routevegetable/Hex_Lattice_CAD/Viewer/docs/glossary.md

# Glossary

Words this project uses in a particular way. Where a term is ordinary English
somewhere else, this is what it means here.

## The structure

**Lattice** — the physical thing: a honeycomb of LED-lit edges. Everything
else is a way of addressing part of it.

**Module** — one physical board. A module spans **two tiles** across and one
down, which is why `LatticeWriter` is built with `COLS / 2`.

**Tile** — the unit the geometry is written in: one hexagon's worth of edges
and vertices, addressed `graph.TILE[x, y]`. The grid **wraps** in both
directions, so tile `(-1, 0)` is the one at the far right. Code that measures
distance or direction has to fold the result the short way round — see
`wrapped_step` in `fields/trace.py`.

**Edge class** — `A`–`F`, the six edges belonging to a tile. `C` and `F` are
the vertical ones.

**Edge** — an edge class plus a tile. An `EdgeRef`.

**End** — one end of an edge, `top` or `bottom`. An `EndRef`. This is the
smallest thing a field has a value for, and the thing the renderer writes to.
Note that an end is also *a direction*: travelling "out through an end" means
going from it to the other end of its edge.

**Vertex class** — `ABC`, `ABF`, `CDE`, `DEF`, each named for the edges that
meet there. Within a tile they stack bottom to top in that order: DEF, CDE,
ABC, ABF.

**Vertex** — a vertex class plus a tile. Three ends meet at one.
`ends_cw()` returns them clockwise, and **index 0 is always the vertical**.
At a CDE or an ABF that vertical points *up*; at a DEF or an ABC it points
*down*. That asymmetry is why `FireField` branches at DEF and ABC and goes
straight on everywhere else.

**Row** — a horizontal line of vertices. Four rows to a tile, so a lattice
`graph.height` tiles tall has `graph.height * 4` of them. Every step of an
upward path crosses exactly one.

**Filament** — one of the four LED runs at an end. `lattice[end][0..3]`.
Eight pixels to an edge.

## The effect chain

**Field** — AKA a 'scalar field'. A thing which produces some scalar value for every 'end' in the lattice.
A field is essentially a function: `get(now, end) -> float`.
Fields are expressions, built from combining other fields with operators like `+ - * /`.
Fields are attached to parts of the control surface - knobs/CCs and notes.
A field may share a control with another field.
Fields plug into **slots**.

**Effect** — Code which draws on the lattice. An effect has a number of **slots**, which receive values from fields.
An effect is essentially a function: `render(now, lattice, graph)`.
Effects are applied 'in order'. Note that it doesn't output things to draw - instead,
it mutates the latticewriter - this allows an effect to operate on the outputs of previous effects,
for the sake of blending and other transformations.

**Slot** — A thing on an effect that a field plugs into. It has a name.

**Muted** — An effect that is silenced without leaving the patch. It is skipped
when drawing, so the rig looks as if it were not there, while its slots keep
their fields. The patch records the effects that are muted (`muted`);
a patch that does not say has none muted.

**Patch** — An assignment of fields to slots, and a set of control surface CC values.
This is everything that makes a given effect chain's behavior.
The whole patch is replaced on post by the UI, which sends every slot it
knows about even when only one of them changed. A patch is the whole picture
to whoever applies it: a slot it does not mention ends up empty.

**Preset** — a numbered patch, 0–15, one `presets/NN.json` each. Every slot in
the bank always holds a patch; one with no file holds a patch that says
nothing, which applies cleanly and blanks the rig.

**Bank** — `PresetBank`. Holds two copies of every preset: the **cache**, which
is live and may have been edited, and the **stored** copy, which is what is on
disk.

**Dirty** — a preset whose cache differs from its file. Shown as an amber
number in the preset list and an amber dot on the preset chip. Saving writes
the cache out; reverting throws it away and reads the file back.

**Rig** — the *vocabulary*, as opposed to the settings: which fields exist,
which slots exist (including empty ones), what the bank holds. Served by
`/rig`. A patch names things; the rig says what there is to name.

**Console** — the one thread-safe way in. The render loop holds its lock for a
whole frame, so the API thread can never land a patch halfway through one.

## MIDI

**Control** — a knob or a pad the instrument watches. `cc 77`, `note 42`.

**Comment** — what a control is *for*, as `field.role` — `rotary.period`,
`fire.rate`. A control can have several, because more than one field can watch
the same knob. Shown in the knob readout and on the Configuration → MIDI page.

**`MIDIFor`** — a MIDI object that names what it is asking on behalf of.
`midi.for_("rotary").cc(KA5, "period")` leaves the comment `rotary.period`.
Fields are handed one of these rather than the MIDI object itself.

**Watched** — a control something actually asked for. A stray that merely
turned up on the wire (a bank select, an all-notes-off) still gets recorded so
it can be seen arriving, but it is not a setting and never enters a preset.
That filter is what keeps **dirty** meaningful: the fold only merges, never
prunes, so folding strays would re-dirty a just-committed preset.

**Hidden** — plumbing rather than a knob. The 16 step buttons are hidden: they
are watched and saved, but picking a preset is not someone turning a knob, so
they stay out of the readout.

**Pressure** — a note's aftertouch. Set from the velocity when the key goes
down, moved by polytouch after that, and back to 0 when the key comes up.
Both forms of release clear it: a note-off, and a note-on of velocity 0,
which is how some boxes say the same thing.

**Step buttons** — CCs 20–35, one preset each. A press arrives as 127. A
program change of 0–15 does the same thing.

## The web UI

**Tab bar** — the top row: Controls, Effects, Configuration. Picks which page
is showing. The frame rate, preset chip, save and revert sit to its right.

**Sub bar** — the row under the tabs. What it indexes depends on the tab:
effects, fields, or the parts of the setup.

**Page** — the area below the sub bar, filled by whichever tab is up.

**Slot row** — on the Effects page, one slot of the chosen effect. Tapping it
opens the tree editor underneath.

**Tree editor** — how an expression is built by thumb: each operand is either
a field (𝑓(x)), a constant (a slider) or a `math` node with two operands of
its own. It writes back only when every operand is filled.

**Picker** — the modal over the page, used to choose a field and to list
presets.

**Knob readout** — the bar that appears along the bottom for two seconds
whenever a watched knob moves, showing what it is for, its value and a dial.
Preset loads do not raise it: a knob a preset put back is not one anybody
turned.

**Preset chip** — the top-right button showing which preset is playing, amber
with a dot when it has unsaved edits. Tapping it opens the preset list.

### The v3 page

`/static/v3.html` is a second page onto the same rig, laid out for a desktop. It is
plain static files and reads the same API as the others. Its parts:

**Preset bar** — the row across the top: a cell for each of the first sixteen
presets, save and revert for the one playing, undo and redo, a label for its name, a *named*
menu to play a preset by name, and *save copy as…*. That asks for a name and
shows every number the bank holds, each with the name it has; you pick the one
the copy goes to, starting from the lowest free number past the first sixteen,
and picking one that already holds something asks before it is replaced. The
page then reads the playing preset, writes it to that number with the name and
commits it - the same writes as any other edit. *New preset…* is the same dialog and picker, but what it writes is a blank
patch: every effect is in the chain, no slot has anything plugged in, nothing is
muted, and no knob is listed. It plays the new preset afterwards, ready to fill in.
The page cannot delete a preset: the API has no way to.

**Undo** — the page keeps the last 64 states a preset was in before an edit (muting,
adding, removing or moving an effect, plugging a slot, pointing a control at a
knob), knobs included, and undo and redo walk back and forward through them, as
on the touch layout. Each step is an ordinary write of an ordinary patch, so the
instrument knows nothing about it, and the history is lost when the page is
reloaded. Turning a knob is not an edit of its own and is not undone; it comes
back with the next step, since each record holds where the knobs were. A new
edit after an undo ends redo.

**Effect card** — one effect in the playing preset. Its switch **mutes** it, which is an edit to the preset like any other, its
bin takes it out of the preset, and opening it shows its slots. Cards run down
the left half; a plus adds an effect, at the end. The order of the cards is the
order the effects are drawn in, one on top of the next: drag a card by its grip
to move it, which is an edit to the preset like any other. A button at the right
of the preset bar lets the cards take the whole width of the window, or puts them
back in the left half; it is kept in the browser and is not part of any preset.

**Slot box** — one slot of an open card, with a header that says how it is
driven.

**Drive** — how a slot gets its value: a *constant* (a plain number), a *field*
it follows, or a *formula*.

**Knob** — a dial under a slot for a control that one of its fields asks for,
named `field.role` (for example `param_a.value`) with its cc beside it. Drag it
up and down to turn that knob from the page; it follows the desk when the knob
is turned there. Turning one edits the preset, as a hand on the desk does. Tap
one instead and it waits for you to turn a knob at the desk, then listens to
that one from then on; tap it again to let go. That is an edit too, kept or
dropped with the save and revert buttons in the preset bar.
A turned copy of a rotary, such as `rotary180`, shows the dials of the rotary it copies, since they share the knobs.

**Field menu** — the searchable list for plugging a field into a slot. Fields
come in groups: the rest, faders, pads and artnet. The page works out which group
a field is in from its name and kind. The slots of an effect are listed hue, value,
sat, then the rest A to Z, whatever order the effect declares them in. The page works out which group
a field is in from its name and kind. The slots of an effect are listed hue, value,
sat, then the rest A to Z, whatever order the effect declares them in.

**Hue wheel** — how a hue slot is set: one thumb for a constant, two for the
range of a field, or of a formula that cannot leave 0–1 (fields count as 0–1). Any slot called `hue`, or `hue_` and something, gets it.

**Formula editor** — opened by a slot's ƒ. A formula is made of **operations**,
each of two **operands**; an operand is a field or a constant. Each level is a
nested coloured box. A formula is not applied until every operand is filled in.
In an operation, *swap* exchanges its two sides, *+ outer* makes the whole of it
the first half of a new operation, and × removes it, keeping its first operand;
a *+* on a single operand pairs it with a new one. A part can be dragged onto
another operand of the same formula, and the two **trade places**.

## Running

**Frame** — one pass of the render loop: clear the lattice, read MIDI, let
every effect draw, send it.

**Tick** — `MIDI.tick()`, draining the MIDI port once per frame. Messages take
effect in the order they arrived, and a program change loads its preset on the
spot, so a control sent after one lands on the new preset.

**Art-Net universe** — 512 channels of DMX arriving over UDP 6454, read as an
image. Each tile is a 2×2 square of pixels, one per vertex. Four universes,
each giving `r`, `g`, `b` and their average as fields.
