routevegetable/Hex_Lattice_CAD/MK4S Node.3mf

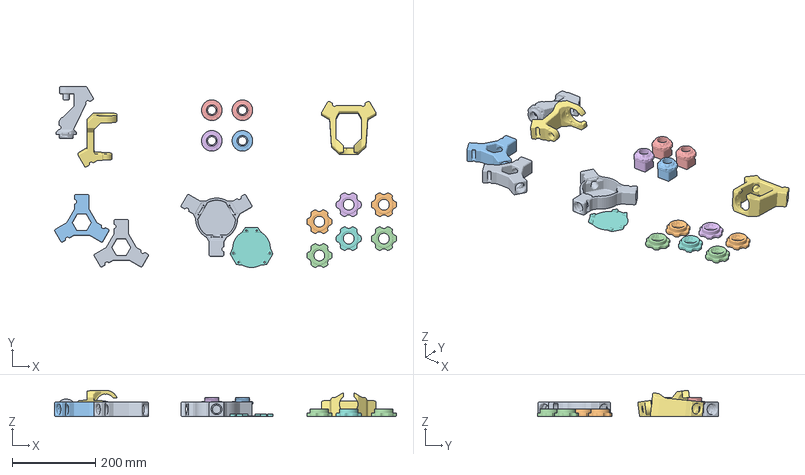
[picture p1: CAD file, 2026-09-07]
MK4S Node.3mf
824.0 x 436.1 x 63.7 mm
Hinge Node 6 - Part 2 (3).stl
Lil Screw Node - Part 3.stl x 6
Lil Node - Part 1 (5).stl x 2
Lil Screw Node - Part 1 (7).stl x 4
Hinge Node 6 - Part 1 (4).stl
Lil Screw Node - Part 1 (6).stl
Smart Node - Part 2 (2).stl
Smart Node - Part 1 (2).stl
