routevegetable/Hex_Lattice_CAD/Module PCB/Hex Lattice.stl

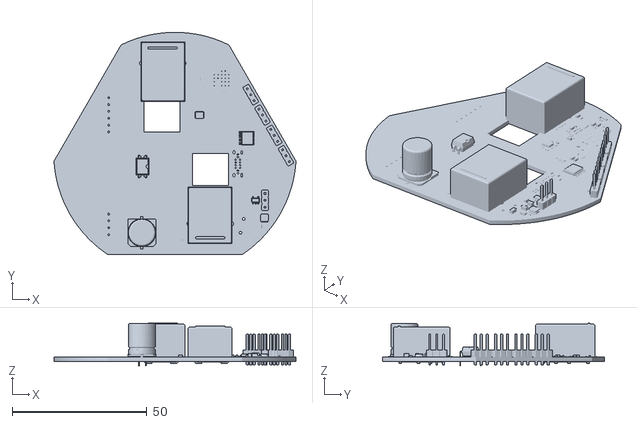
[picture p2: CAD file, 2026-07-01]
Module PCB/Hex Lattice.stl
89.8 x 82.5 x 15.9
