routevegetable/Hex_Lattice_CAD/Bambu Node.3mf

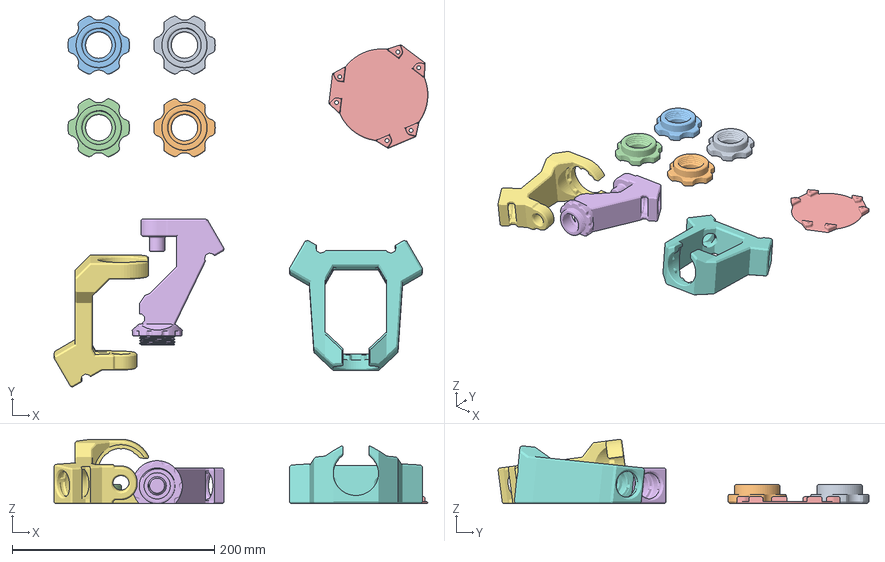
[picture p3: CAD file, 2026-09-05]
Bambu Node.3mf
369.4 x 366.6 x 63.7 mm
Smart Node - Part 2 (1).stl
Hinge Node 6 - Part 2 (3).stl
Hinge Node 6 - Part 1 (4).stl
Lil Screw Node - Part 1 (6).stl
