routevegetable/Hex_Lattice_CAD/Prusa Squish.3mf

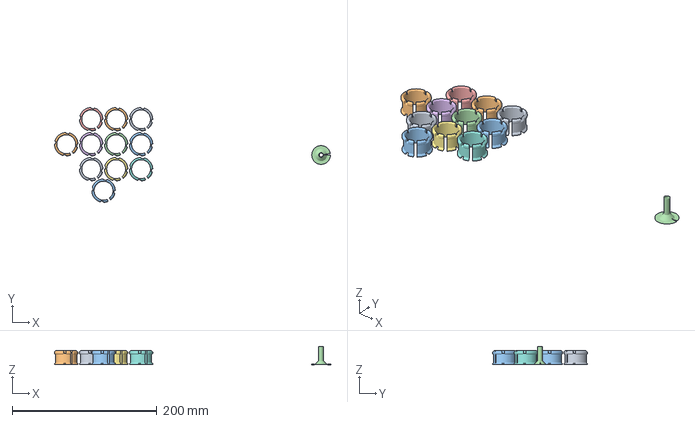
[picture p5: CAD file, 2026-09-05]
Prusa Squish.3mf
380.7 x 130.9 x 25.5 mm
Squish 4 - Part 2 (1).stl x 11
Hinge Node 6 - Part 6.stl
