routevegetable/Hex_Lattice_CAD/Viewer/hinge_obj/todo.md

Multiple room types
Desk
Chop Antennas off the top
Mood lights for the walls
For the 2x4 thing, consider whether we want to have 'straight' as an angle permissible by the hinge.
Coordinate (given the coord of an edge, need a mapping to figure out what module owns it)
Multiple stored profiles for settings
Save/Load profiles with downloadable json
Fake people
