routevegetable/Hex_Lattice_CAD/Module PCB/Hex Lattice.kicad_pcb

## KiCad design Module PCB/Hex Lattice.kicad_pcb (2026-07-01)

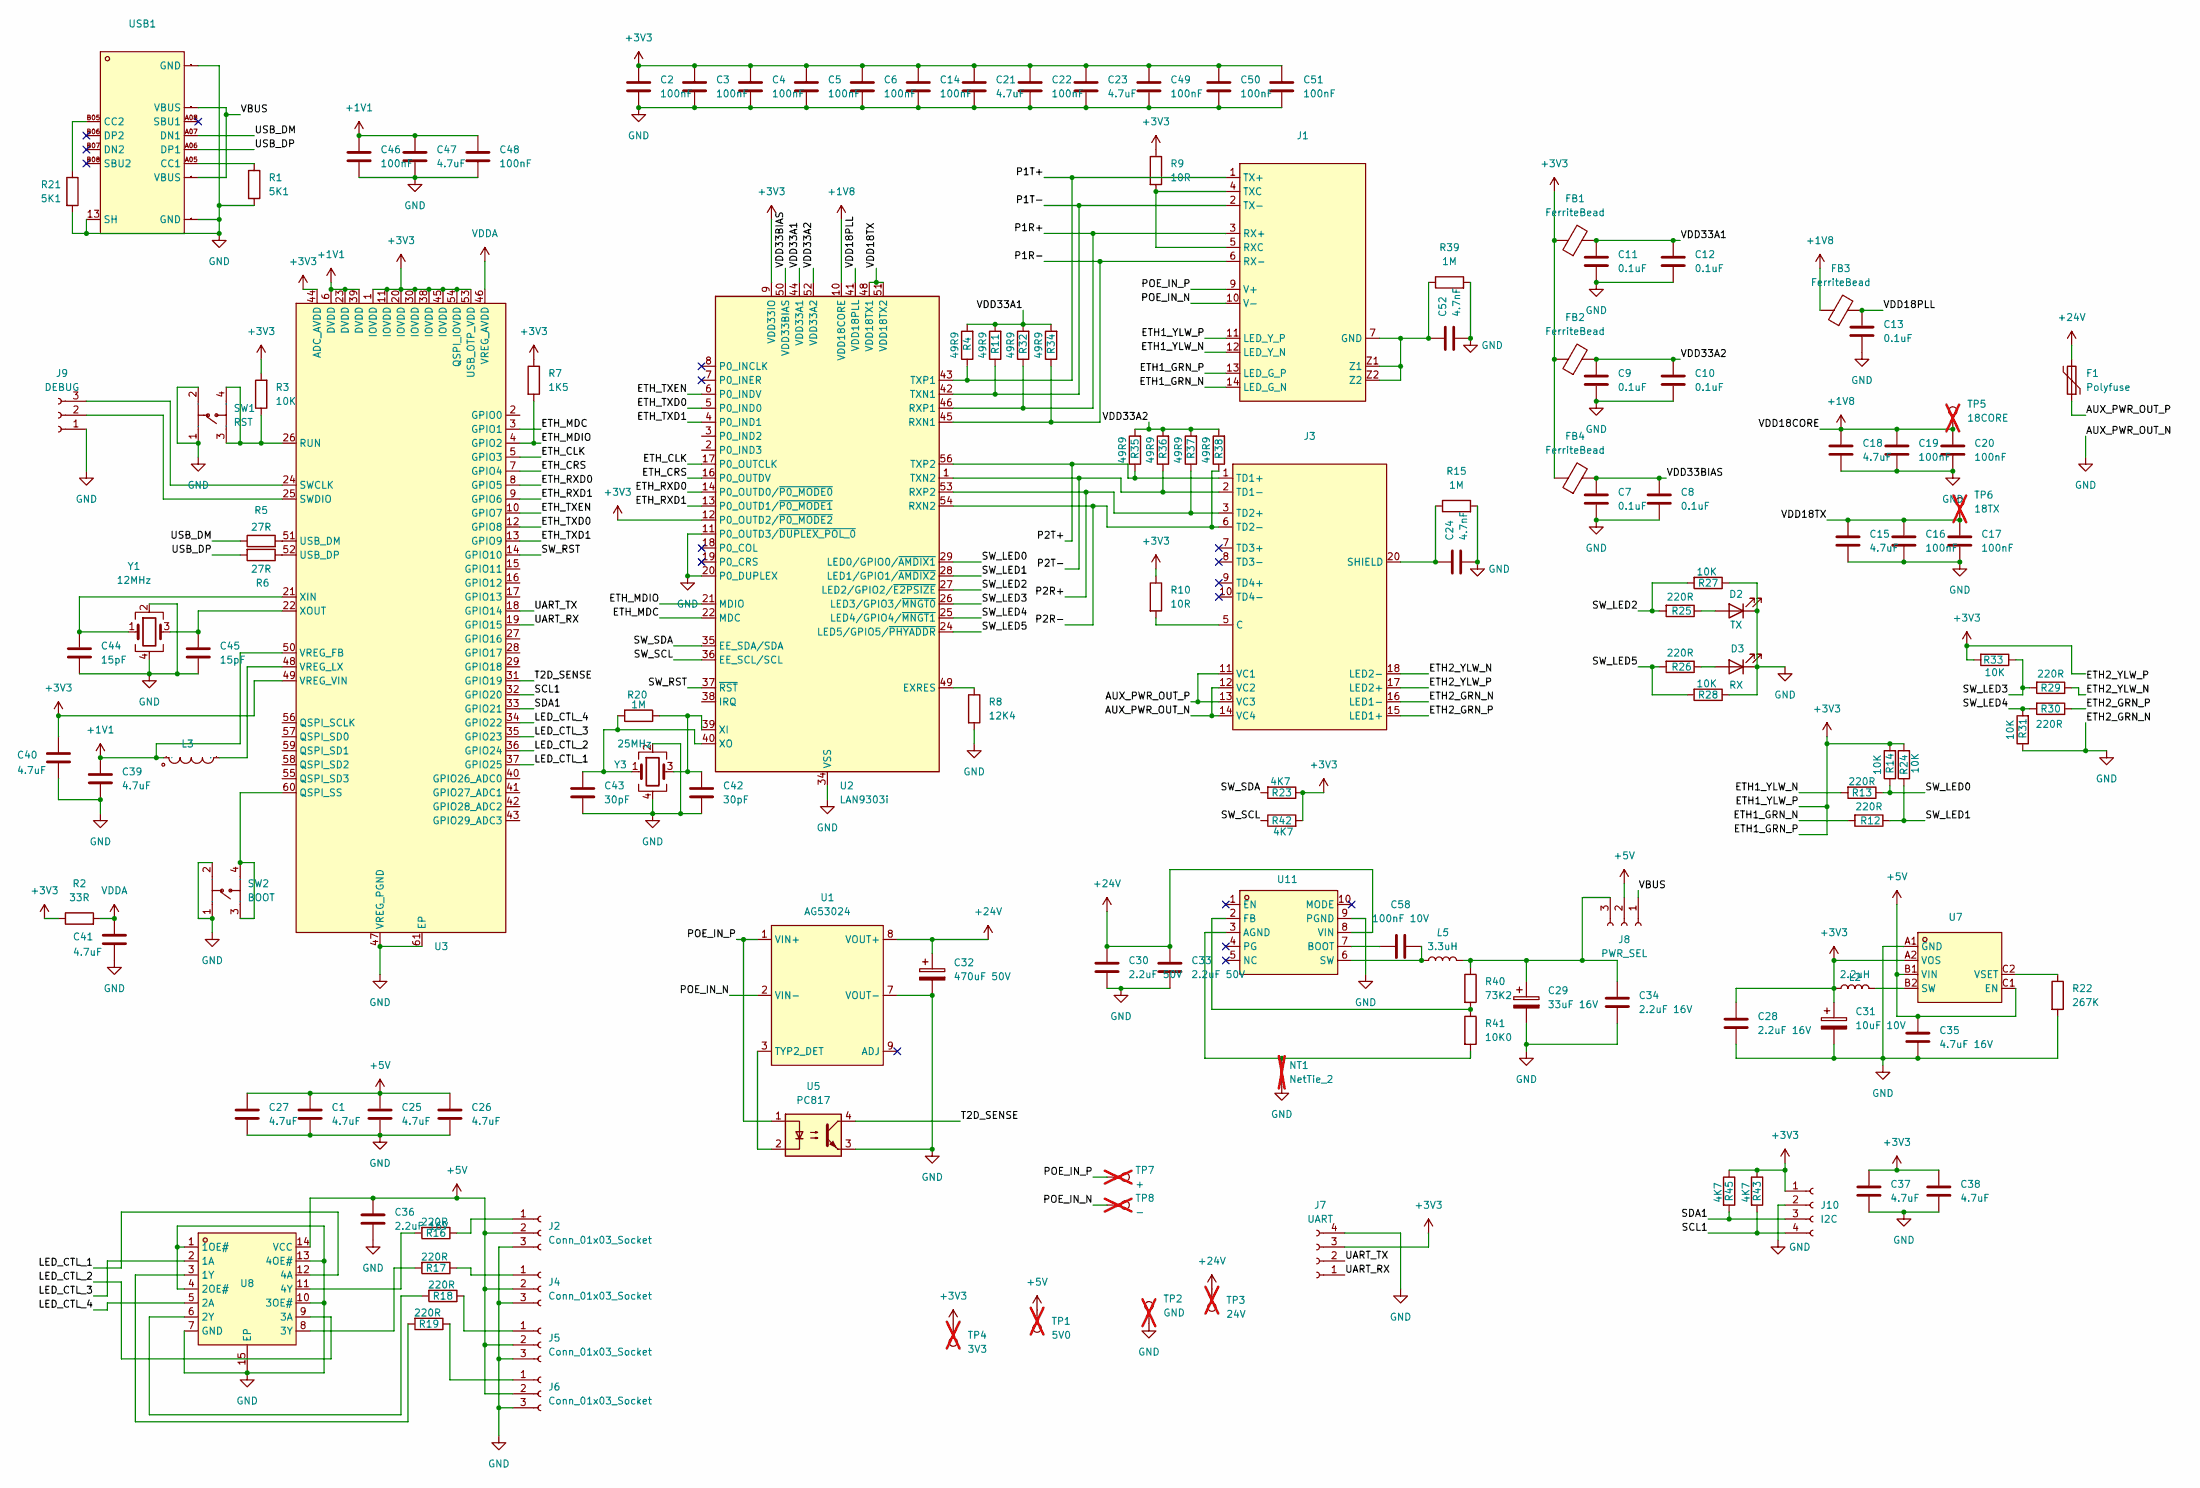
[picture p6: schematic Hex Lattice.kicad_sch]

Parts:
C1, C25, C26, C27, C37, C38: 4.7uF; C_0805_2012Metric; LCSC C380343
C2, C3, C4, C5, C6, C14, C16, C17, C19, C20, C22, C46, C48, C49, C50, C51: 100nF; C_0201_0603Metric; LCSC C6119757
C7, C8, C9, C10, C11, C12, C13: 0.1uF; C_0201_0603Metric; LCSC C6119757
C15, C18, C21, C23, C39, C40, C41: 4.7uF; C_0603_1608Metric; LCSC C7419427
C24, C52: 4.7nF; C_1206_3216Metric; LCSC C784438
C28, C34, C36: 2.2uF 16V; C_0805_2012Metric; LCSC C167029
C29: 33uF 16V; CP_Elec_5x5.4; LCSC C970668
C30, C33: 2.2uF 50V; C_0805_2012Metric; LCSC C2903667
C31: 10uF 10V; CP_Elec_4x5.8; LCSC C401860
C32: 470uF 50V; CP_Elec_10x12.5; LCSC C22469994
C35: 4.7uF 16V; C_0805_2012Metric; LCSC C22399641
C42, C43: 30pF; C_0201_0603Metric; LCSC C5142545
C44, C45: 15pF; C_0201_0603Metric; LCSC C22374851
C47: 4.7uF; C_0402_1005Metric; LCSC C33595851
C58: 100nF 10V; C_0201_0603Metric; LCSC C6119757
D2: TX; LED_0402_1005Metric; LCSC C74338
D3: RX; LED_0402_1005Metric; LCSC C74338
F1: Polyfuse; Fuse_Bourns_MF-RG300; LCSC C2680602
FB1, FB2, FB3, FB4: FerriteBead; L_0603_1608Metric; LCSC C3032643
J1: RJ45-TH_ARJP11A-MASA-B-A-EMU2; Manufacturer Part HR861153C; LCSC C19724782
J2, J4, J5, J6: Conn_01x03_Socket; PinHeader_1x03_P2.54mm_Vertical; LCSC C429954
J3: RJ45-TH_DGUK111Q334AB2A2DP057; Manufacturer Part DGUK111Q334AB2A2DP057; LCSC C19725175
J7: UART; CONN-TH_ZH-4A; LCSC C722937
J8: PWR_SEL; PinHeader_1x03_P2.54mm_Vertical; LCSC C429954
J9: DEBUG; PinHeader_1x03_P2.54mm_Vertical; LCSC C2937625
J10: I2C; CONN-SMD_4P-P1.00_ZX-SH1.0-4PLN; LCSC C7430453
L2: 2.2uH; L0806; LCSC C337893
L3: 3.3uH; IND-SMD_L2.0-W1.6_AOTA-B201610S3R3-101-T; Manufacturer Part AOTA-B201610S3R3-101-T; LCSC C42411119
L5: 3.3uH; L_Murata_LQH55DN_5.7x5.0mm; LCSC C48579566
NT1: NetTie_2; NetTie-2_SMD_Pad0.5mm; not fitted
R1, R21: 5K1; R_0402_1005Metric; LCSC C49652827
R2: 33R; R_0201_0603Metric; LCSC C49654095
R3, R14, R24, R27, R28, R31, R33: 10K; R_0201_0603Metric; LCSC C49653975
R4, R11, R32, R34, R35, R36, R37, R38: 49R9; R_0201_0603Metric; LCSC C49653934
R5, R6: 27R; R_0201_0603Metric; LCSC C49654512
R7: 1K5; R_0201_0603Metric; LCSC C49654140
R8: 12K4; R_0402_1005Metric; LCSC C138060
R9, R10: 10R; R_0201_0603Metric; LCSC C49653825
R12, R13, R25, R26, R29, R30: 220R; R_0201_0603Metric; LCSC C49654383
R15, R39: 1M; R_0402_1005Metric; LCSC C49652954
R16, R17, R18, R19: 220R; R_0402_1005Metric; LCSC C49653096
R20: 1M; R_0201_0603Metric; LCSC C49654212
R22: 267K; R_0402_1005Metric; LCSC C49254102
R23, R42, R43, R45: 4K7; R_0201_0603Metric; LCSC C49654757
R40: 73K2; R_0402_1005Metric; LCSC C50669973
R41: 10K0; R_0402_1005Metric; LCSC C52677569
SW1: RST; SW-SMD_4P-L5.2-W5.2-P3.70-LS6.4; Manufacturer Part TS1187A16015; LCSC C22375382
SW2: BOOT; SW-SMD_4P-L5.2-W5.2-P3.70-LS6.4; Manufacturer Part TS1187A16015; LCSC C22375382
TP1: 5V0; TestPoint_Pad_D3.0mm; not fitted
TP2: GND; TestPoint_Pad_D3.0mm; not fitted
TP3: 24V; TestPoint_Pad_D3.0mm; not fitted
TP4: 3V3; TestPoint_Pad_D3.0mm; not fitted
TP5: 18CORE; TestPoint_Pad_D2.0mm; not fitted
TP6: 18TX; TestPoint_Pad_D2.0mm; not fitted
TP7: +; TestPoint_Pad_D3.0mm; not fitted
TP8: -; TestPoint_Pad_D3.0mm; not fitted
U1: AG53024; AG53000
U2: LAN9303i; QFN-56-1EP_8x8mm_P0.5mm_EP5.9x5.9mm_ThermalVias; LCSC C633501
U3: QFN-60_L7.0-W7.0-P0.40-TL-EP3.4; Manufacturer Part RP2354A; LCSC C41378174
U5: PC817; DIP-4_W7.62mm; LCSC C52092020
U7: DSBGA-6_L1.4-W1.0-R2-C3-P0.40-BL; Manufacturer Part TPS62840YBGR; LCSC C2071139
U8: DHVQFN-14_L3.0-W2.5-P0.50-BL-EP; Manufacturer Part 74AHCT125BQ,115; LCSC C554499
U11: VQFN-HR-10_L3.0-W3.0_RPA; Manufacturer Part TPS56637RPAR; LCSC C841386
USB1: USB-C-TH_MC-110LD-L137; Manufacturer Part MC-110LDS-L150; LCSC C22374560
Y1: 12MHz; Crystal_SMD_3225-4Pin_3.2x2.5mm; LCSC C5182759
Y3: 25MHz; CRYSTAL-SMD_4P-L1.6-W1.2-BL; LCSC C51289919

Connections:
+1V1: C39.1, C46.1, C47.1, C48.1, L3.2, U3.6 (DVDD), U3.23 (DVDD), U3.39 (DVDD), U3.50 (VREG_FB)
+1V8: C18.1, C19.1, C20.1, FB3.1, TP5.1, U2.10 (VDD18CORE), U2.31 (VDD18CORE)
+3V3: C2.1, C3.1, C4.1, C5.1, C6.1, C14.1, C21.1, C22.1, C23.1, C28.2, C31.1, C37.1, C38.1, C40.1, C49.1, C50.1, C51.1, FB1.1, FB2.1, FB4.1, J1.11 (LED_Y_P), J1.13 (LED_G_P), J7.3, J10.1, L2.1, R2.1, R3.2, R7.1, R9.1, R10.1, R14.2, R23.1, R24.2, R33.2, R42.2, R43.1, R45.1, TP4.1, U2.9 (VDD33IO), U2.12 (P0_OUTD2/~P0_MODE2), U2.15 (VDD33IO), U2.23 (VDD33IO), U2.30 (VDD33IO), U2.32 (VDD33IO), U2.33 (VDD33IO), U3.1 (IOVDD), U3.11 (IOVDD), U3.20 (IOVDD), U3.30 (IOVDD), U3.38 (IOVDD), U3.44 (ADC_AVDD), U3.45 (IOVDD), U3.49 (VREG_VIN), U3.53 (USB_OTP_VDD), U3.54 (QSPI_IOVDD), U7.A2 (VOS)
+5V: C1.1, C25.1, C26.1, C27.1, C35.1, C36.2, J2.2, J4.2, J5.2, J6.2, J8.2, TP1.1, U7.B1 (VIN), U7.C1 (EN), U8.14 (VCC)
+24V: C30.2, C32.1, C33.2, F1.2, TP3.1, U1.8 (VOUT+), U11.8 (VIN)
/AUX_PWR_OUT_P: F1.1, J3.11 (VC1), J3.13 (VC3)
/ETH1_GRN_N: J1.14 (LED_G_N), R12.2
/ETH1_YLW_N: J1.12 (LED_Y_N), R13.2
/ETH2_GRN_P: J3.15 (LED1+), R30.1
/ETH2_YLW_N: J3.18 (LED2-), R29.1
/ETH2_YLW_P: J3.17 (LED2+)
/ETH_CLK: U2.17 (P0_OUTCLK), U3.5 (GPIO3)
/ETH_CRS: U2.16 (P0_OUTDV), U3.7 (GPIO4)
/ETH_MDC: U2.22 (MDC), U3.3 (GPIO1)
/ETH_MDIO: R7.2, U2.21 (MDIO), U3.4 (GPIO2)
/ETH_RXD0: U2.14 (P0_OUTD0/~P0_MODE0), U3.8 (GPIO5)
/ETH_RXD1: U2.13 (P0_OUTD1/~P0_MODE1), U3.9 (GPIO6)
/ETH_TXD0: U2.5 (P0_IND0), U3.12 (GPIO8)
/ETH_TXD1: U2.4 (P0_IND1), U3.13 (GPIO9)
/ETH_TXEN: U2.6 (P0_INDV), U3.10 (GPIO7)
/LED_CTL_1: U3.37 (GPIO25), U8.12 (4A)
/LED_CTL_2: U3.36 (GPIO24), U8.9 (3A)
/LED_CTL_3: U3.35 (GPIO23), U8.2 (1A)
/LED_CTL_4: U3.34 (GPIO22), U8.5 (2A)
/P1R+: J1.3 (RX+), R32.1, U2.46 (RXP1)
/P1R-: J1.6 (RX-), R34.1, U2.45 (RXN1)
/P1T+: J1.1 (TX+), R4.1, U2.43 (TXP1)
/P1T-: J1.2 (TX-), R11.1, U2.42 (TXN1)
/P2R+: J3.3 (TD2+), R37.1, U2.53 (RXP2)
/P2R-: J3.6 (TD2-), R38.1, U2.54 (RXN2)
/P2T+: J3.1 (TD1+), R35.1, U2.56 (TXP2)
/P2T-: J3.2 (TD1-), R36.1, U2.1 (TXN2)
/POE_IN_N: J1.10 (V-), TP8.1, U1.2 (VIN-)
/POE_IN_P: J1.9 (V+), TP7.1, U1.1 (VIN+), U5.1
/SCL1: J10.4, R43.2, U3.32 (GPIO20)
/SDA1: J10.3, R45.2, U3.33 (GPIO21)
/SW_LED0: R13.1, R14.1, U2.29 (LED0/GPIO0/~AMDIX1)
/SW_LED1: R12.1, R24.1, U2.28 (LED1/GPIO1/~AMDIX2)
/SW_LED2: R25.2, R27.2, U2.27 (LED2/GPIO2/~E2PSIZE)
/SW_LED3: R29.2, R33.1, U2.26 (LED3/GPIO3/~MNGT0)
/SW_LED4: R30.2, R31.2, U2.25 (LED4/GPIO4/~MNGT1)
/SW_LED5: R26.2, R28.2, U2.24 (LED5/GPIO5/~PHYADDR)
/SW_RST: U2.37 (~RST), U3.14 (GPIO10)
/SW_SCL: R42.1, U2.36 (EE_SCL/SCL)
/SW_SDA: R23.2, U2.35 (EE_SDA/SDA)
/T2D_SENSE: U3.31 (GPIO19), U5.4
/UART_RX: J7.1, U3.19 (GPIO15)
/UART_TX: J7.2, U3.18 (GPIO14)
/USB_DM: R5.1, USB1.A07 (DN1)
/USB_DP: R6.2, USB1.A06 (DP1)
/VBUS: J8.1, USB1.A04 (VBUS), USB1.A09 (VBUS)
/VDD18PLL: C13.1, FB3.2, U2.41 (VDD18PLL)
/VDD18TX: C15.1, C16.1, C17.1, TP6.1, U2.48 (VDD18TX1), U2.51 (VDD18TX2)
/VDD33A1: C11.1, C12.1, FB1.2, R4.2, R11.2, R32.2, R34.2, U2.44 (VDD33A1), U2.47 (VDD33A1)
/VDD33A2: C9.1, C10.1, FB2.2, R35.2, R36.2, R37.2, R38.2, U2.52 (VDD33A2), U2.55 (VDD33A2)
/VDD33BIAS: C7.1, C8.1, FB4.2, U2.50 (VDD33BIAS)
GND: C1.2, C2.2, C3.2, C4.2, C5.2, C6.2, C7.2, C8.2, C9.2, C10.2, C11.2, C12.2, C13.2, C14.2, C15.2, C16.2, C17.2, C18.2, C19.2, C20.2, C21.2, C22.2, C23.2, C24.2, C25.2, C26.2, C27.2, C28.1, C29.2, C30.1, C31.2, C32.2, C33.1, C34.1, C35.2, C36.1, C37.2, C38.2, C39.2, C40.2, C41.2, C42.2, C43.2, C44.2, C45.2, C46.2, C47.2, C48.2, C49.2, C50.2, C51.2, C52.2, D2.1 (K), D3.1 (K), J2.3, J3.12 (VC2), J3.14 (VC4), J3.16 (LED1-), J4.3, J5.3, J6.3, J7.4, J9.1, J10.2, NT1.1, R1.2, R8.2, R15.2, R21.2, R22.2, R27.1, R28.1, R31.1, R39.2, SW1.1, SW1.2, SW2.1, SW2.2, TP2.1, U1.7 (VOUT-), U1.10 (VOUT-), U2.11 (P0_OUTD3/~DUPLEX_POL_0), U2.20 (P0_DUPLEX), U2.34 (VSS), U2.57 (VSS), U3.47 (VREG_PGND), U3.61 (EP), U5.3, U7.A1 (GND), U8.1 (1OE#), U8.4 (2OE#), U8.7 (GND), U8.10 (3OE#), U8.13 (4OE#), U8.15 (EP), U11.9 (PGND), USB1.13 (SH), USB1.A01 (GND), USB1.A12 (GND), Y1.2, Y1.4, Y3.2, Y3.4
unnamed: C24.1, J3.19 (SHIELD), J3.20 (SHIELD), R15.1
unnamed: D2.2 (A), R25.1
unnamed: D3.2 (A), R26.1
unnamed: C52.1, J1.7 (GND), J1.Z1, J1.Z2, R39.1
unnamed: J1.4 (TXC), J1.5 (RXC), R9.2
unnamed: J2.1, R16.1
unnamed: J3.4 (C), J3.5 (C), R10.2
unnamed: J4.1, R17.1
unnamed: J5.1, R18.1
unnamed: J6.1, R19.1
unnamed: C29.1, C34.2, J8.3, L5.2, R40.1
unnamed: J9.2, U3.25 (SWDIO)
unnamed: J9.3, U3.24 (SWCLK)
unnamed: U1.3 (TYP2_DET), U5.2
unnamed: R8.1, U2.49 (EXRES)
unnamed: C42.1, R20.1, U2.39 (XI), Y3.3
unnamed: C43.1, R20.2, U2.40 (XO), Y3.1
unnamed: SW2.3, SW2.4, U3.60 (QSPI_SS)
unnamed: R3.1, SW1.3, SW1.4, U3.26 (RUN)
unnamed: R5.2, U3.51 (USB_DM)
unnamed: R6.1, U3.52 (USB_DP)
unnamed: L3.1, U3.48 (VREG_LX)
unnamed: C44.1, U3.21 (XIN), Y1.1
unnamed: C45.1, U3.22 (XOUT), Y1.3
unnamed: L2.2, U7.B2 (SW)
unnamed: R22.1, U7.C2 (VSET)
unnamed: R19.2, U8.3 (1Y)
unnamed: R18.2, U8.6 (2Y)
unnamed: R17.2, U8.8 (3Y)
unnamed: R16.2, U8.11 (4Y)
unnamed: NT1.2, R41.2, U11.3 (AGND)
unnamed: C58.1, U11.7 (BOOT)
unnamed: R40.2, R41.1, U11.2 (FB)
unnamed: C58.2, L5.1, U11.6 (SW)
unnamed: R1.1, USB1.A05 (CC1)
unnamed: R21.1, USB1.B05 (CC2)
VDDA: C41.1, R2.2, U3.46 (VREG_AVDD)

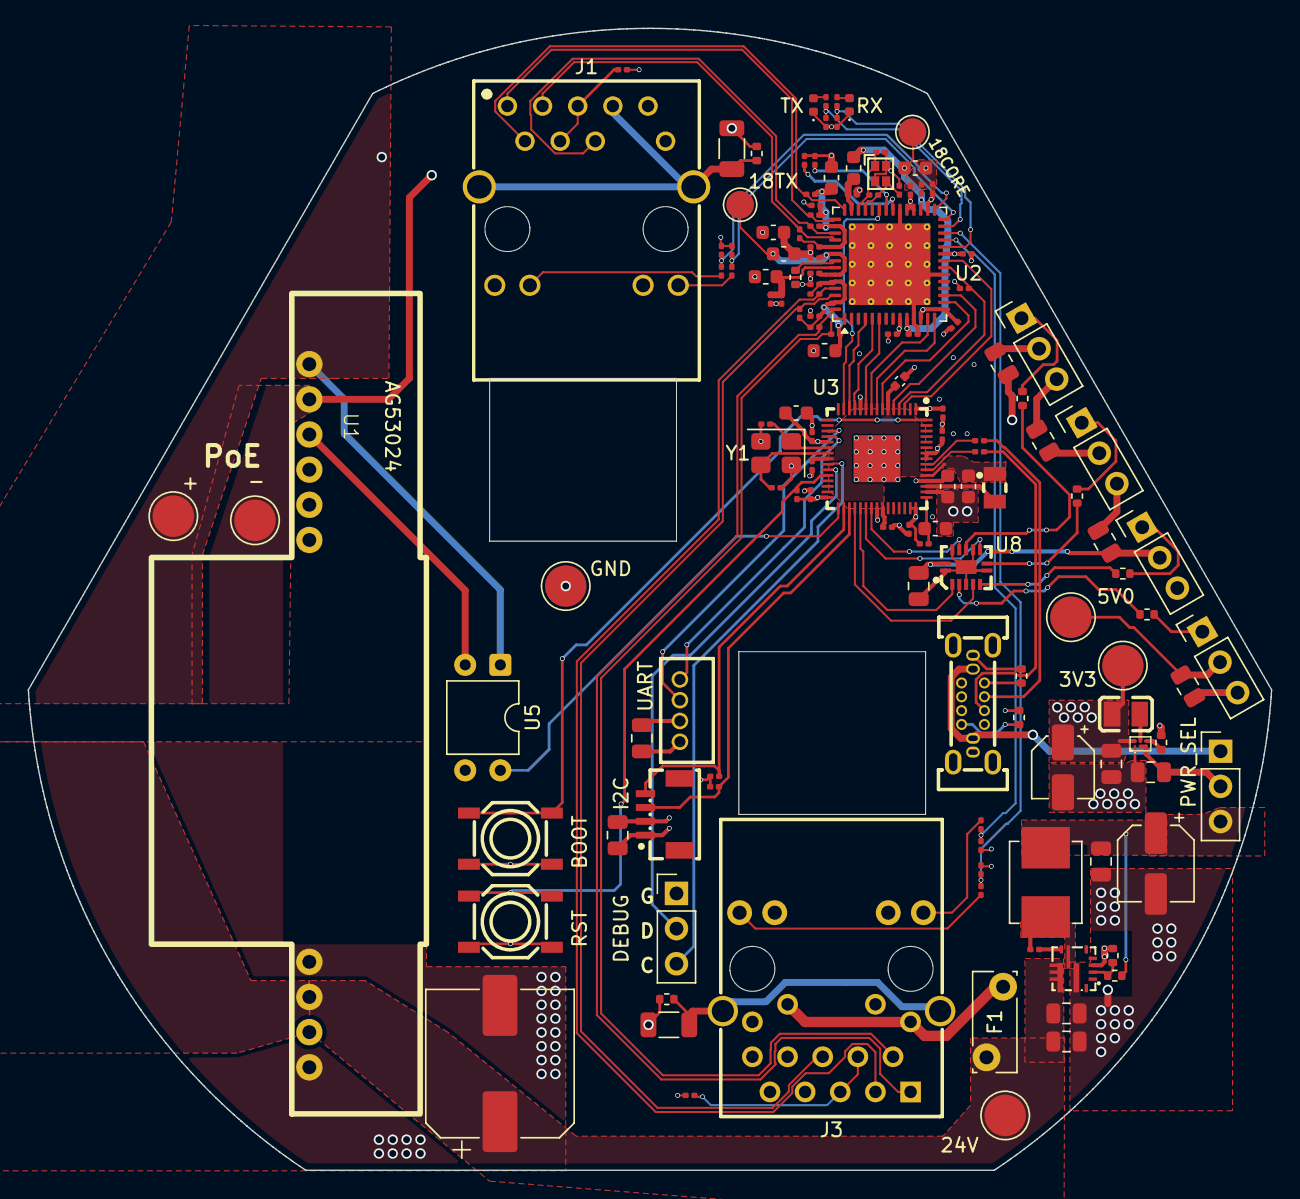
[picture p7: board Hex Lattice.kicad_pcb from above]

Board: 4 copper layers, 89.8 x 82.5 mm, 138 parts (0 on the bottom side), 93 nets.
