routevegetable/Hex_Lattice_CAD/(commit log)

2026-07-01 New repo structure
    [BOM-Hex Lattice.csv, BOM-LED Ring.csv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]
2026-07-03 Added Orca Projects
    [Bambu Node.3mf, MK4S Node.3mf, Prusa Squish.3mf]
2026-07-19 Viewer: hex-lattice renderer, filament render module, and module-edge spec
    - index.html: three.js walkthrough viewer (instanced lattice, 3mm emissive
    filament tubes with bloom, first-person controls, room + cushions,
    reflection probe, hot-reload of app.ts)
    - app.ts: hot-reloaded render(t) returning a Frame of rows of modules
    - module-edges.svg: standardized module edge allocation (A-L), four hexes,
    neighbour edges colour-coded by source
    - indexing.md: edge/end/hex coordinate-system design notes
2026-08-05 Viewer and LED Ring Stuff
    [Bambu Node.3mf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]
2026-08-08 Switch to UDP multicast
2026-08-09 frame fixes
2026-08-09 Add fixed frame.ts
2026-08-10 Update mk4s 3mf
    [MK4S Node.3mf]
2026-08-14 "pylattice" library. New frame format shape.
2026-09-05 Cleaned up CAD
    [Bambu Node.3mf, Bambu Squish.3mf, MK4S Node.3mf, Prusa Squish.3mf]
2026-09-07 Latest code messing. Some 3mf updates
    [MK4S Node.3mf]
2026-09-24 Tidy lite2d nodes, untrack build files, share VS Code Black setting
    - lite2d: draw joints as a plain rect; fixes nodes rendering ~0.4px wide
    - Remove one-off extract_node_shape.py (output was already inlined)
    - Stop tracking __pycache__/*.pyc and LITE2D_PLAN.md (now gitignored)
    - Add .vscode/settings.json: Black format-on-save for Python
2026-10-28 Slots: a sat slot on BgWaves and WobbleNet
    BgWaves had no saturation of its own (it drew at full) and WobbleNet drew at a
    fixed 0.7. Each now has a sat slot like MapFiber's. A slot nothing is plugged
    into still holds 0, as ever, so presets 0-15 say what each effect did before:
    bg_waves and bg_waves2 sat 1, net sat 0.7. A preset that does not say gets 0.
2026-10-28 Effects: sat is a plain slot, with no fallback behind it
    bg_waves still took its saturation as an optional field and drew at full when
    there was none, and wobble() kept a 0.7 default. Both were defaults for a sat
    that now has a slot of its own, and a slot nothing is plugged into holds 0
    like any other. bg_waves now requires bg_sat, and wobble requires sat.
    The three Pluck callers of wobble have no sat slot and drew at 0.7 before, so
    they pass 0.7 where they used to get it by default. Rendering is unchanged for
    every preset, which all carry explicit sat values.
2026-10-28 Mute: a patch lists the effects that are silenced
    Patch.muted is a set of effect names, empty by default; a muted effect stays in
    the patch, slots and all, but Console.chain() skips it. Nothing muted is the
    normal state, so it is the empty one, and an effect that is new or renamed
    plays instead of falling silent. Older preset files have no key and give an
    empty set. It is saved with the preset and travels in the patch the UI already
    sends - no separate REST method.
2026-10-28 chain(): say plainly that muted effects keep their slots
2026-10-28 v3: a desktop page on the REST API as it is on main
    /v3 is the page from calder-v3, reworked for the API main has:
    - mute is a field of the patch (muted), so it is an edit like any other and
    there is no PUT /muted
    - the preset bar shows the first sixteen; whether a preset holds anything is
    worked out from its stored copy, since the rig does not list them
    - save copy as... opens a picker over every number the bank holds, starting
    from the lowest free one past the bar, and asks before replacing one that
    holds something - as /mobile's preset list does
    - the field menu's groups and the order of an effect's slots are worked out
    on the page, from what /rig already says; no server change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
2026-10-28 v3: new preset, with every slot blank
    A button beside save copy as... opens the same dialog - a name and a number
    from the bank - but writes a blank patch instead of a copy of the one playing:
    every effect in the chain, nothing plugged into any slot, nothing muted, no
    knobs listed. It commits it and plays it, since it is made to be filled in.
2026-10-28 v3: undo and redo, as on the touch layout
    Each edit the page makes to the playing preset - mute, the chain, a slot, a
    control's knob - first keeps the patch as it stood, whole and read just now,
    in a ring of 64. Undo and redo write a record back to its preset and play it.
    Two buttons in the preset bar, after save and revert. The history is the
    page's own: nothing on the server knows about it.
2026-10-30 Presets: every preset has a sat slot for each effect that has one, 0 where there was none
2026-10-30 Preset 16 (believe-1): remapped CCs (fader_a/b, param_a/b, rotary, random.period, trace.aim, ripple.speed), the random blend on fader_b, and ripple2 zaps scaled by rotary + 0.8
2026-10-30 Presets: 00-15 as they are on main, without the sat: 0 lines
    An unset slot already holds 0, so the lines changed nothing about how these
    presets load.
2026-11-03 Trace lines, and the line machinery they run on
    mask.py learns to walk the lattice's lines. An edge family - d1, d2 or h -
    leaves exactly two of every vertex's three ends in it, so there is never a
    choice of where to go next, and following that gathers the family into whole
    lines. Those get cut where they would run off the top, since only sideways is
    really joined up; a horizontal one has nothing to cut and meets itself.
    random_lines lights some number of whole lines from one family, re-picked on
    the randomize pad. The count takes a prefix of a shuffle, so turning it up
    adds lines without disturbing the ones already lit.
    trace_lines is trace held to those lines. There are six ways out of a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
2026-11-04 Patch: notes, a line of the player's own words for each effect
    effect name -> text, kept in the preset beside its slots and saved, loaded
    and copied with the rest of the patch. Only for reading: nothing renders
    from it. An effect with no note has no entry.
2026-11-04 hexes: comment the sparse_climb start, drop a stray print
2026-11-04 Effect: light_all_fibers, three of them
    MapFiber lights more of an end's LEDs as value rises, each dimmer than the
    last. This lights all four at the value every time: 25% is four LEDs at 25%,
    80% is four at 80%. Same slots (value, hue, sat) and the same three copies
    as map_fiber, in the chain after map_fiber3.
2026-11-04 Hue slots are not clamped to 0-1
    Every combination held its result to 0-1, which is right for a brightness
    or a saturation but not a hue: a hue wraps round, so 1.05 is 0.05 and -0.1
    is 0.9. Expressions in a hue slot - anything named hue, hue_1, a_hue - were
    being cut off at 1 and at 0 on every step, so a formula like
    param_a * 0.1 + 1.0 sat on 1.0 and a negative coefficient did nothing.
    CombinedField takes a clamp flag (on by default) and decode_field passes it
    down a whole expression; Patch.apply turns it off for hue slots. hsv()
    already wraps. Other slots are unchanged.
2026-11-05 Choice knobs index the CC rather than spreading over it
    A CustomChoice spread over 0-127 cannot take a new option: adding one
    moves all the others, so every recording of that knob comes back meaning
    something else. random_lines.count was worse, its length coming from the
    widest family of lines on the lattice, so the same preset on a different
    sized lattice lit a different number of lines. rotary.parts,
    v_rotary.parts, loops.copies, random_lines.count and trace_lines.mode now
    index the CC directly, as scope.pattern and loops.shape always did.
    37 presets held positions from the old layout.
    py/migrations/2026-11-04-choice-knobs moves each one to the position that
    reads the same, keeps all 57 p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
2026-11-05 Time every slot get, and put the numbers on a System tab
    A slot is where a field meets an effect, and it is asked once per end per
    frame, so that is the granularity worth measuring. Slot.get brackets the
    field's get with perf_counter_ns and keeps running totals rather than
    samples - count, total, total of squares, worst and best - so nothing on
    that path allocates. fold() turns a second of those into the worst, best,
    mean and spread of one get, and smooths each across seconds, a third of
    the new second at a time.
    The console folds every slot of every effect once a second, inside the
    set_stats the loop already calls, and serves them as Stats.slots keyed
    "effect.slot". A slot nothing asked dr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
2026-11-05 Added loop traces and LFO fields
2026-11-05 Hinge viewer: a toggle to hide the settings panel
    A button on the edge of the view hides the 320px panel and gives the
    canvas the room; the choice is remembered in localStorage.
2026-11-05 v3: redraw the effects list only when what it shows changed
    The poll comes every second and rebuilt the list each time, so it flickered
    under the scrolling. The page now keeps what the list was last drawn from and
    redraws only when that differs; where the knobs sit is left out, since the
    dials follow the socket. Page only - nothing on the server changes.
2026-11-05 v3: a controller map beside the effects, with the Akai MPD232 first
    A picture of the box on the desk, each knob, fader and pad labelled with
    the control it drives and the effects that use it, with the knobs and
    faders following the desk. Hovering a row of the legend under the picture
    lights the matching control, and the other way round. The picture and the
    CC/note table for each box come from surfaces.json (BeatStep Pro and Akai
    MPD232). Knobs are painted once per frame, however many frames the socket
    delivers.
2026-11-05 Controller map: "assign them" for controls a preset uses that are not on the box
    Lists the controls the playing preset's slots read that are not on this
    box and offers to put them on the next free knobs and faders: the four
    general faders on F1-F4, the wipe speeds on any fader, everything else on
    the knobs. Nothing is placed automatically; adding a field to a slot
    leaves its controls where they are. surfaces.json lists each box's faders
    and knobs in the order they are handed out.
2026-11-05 v3: a new preset starts with the box's default controls and an empty chain
    surfaces.json says where each box's defaults go, so a new preset has them
    on the desk, with any that would land there by accident parked on a CC
    nothing sends. No effect has a card until it is added from the menu.
2026-11-05 v3: type a formula instead of building it
    A pencil on each slot swaps the editor for a text box with the same syntax
    as the mobile page, brackets coloured by depth. * binds tighter than +;
    errors are named in place; Enter or "set" applies, Escape backs out.
2026-11-05 v3: a fader dropdown on brightness slots
    A value slot can be multiplied by a fader (fader_a-h) as its outermost
    step. It is chosen from a dropdown on the slot, not drawn in the
    expression; faders another slot already reads are greyed out, and a folded
    effect still shows which fader its brightness is on.
2026-11-05 v3: turn a brightness fader from its slot and its folded header
    The fader is outside the expression, so its dial was no longer found.
    The slot lists it again, and a folded effect shows a compact dial beside
    its fader tag.
2026-11-05 Presets 16-44: wrap the hues that clamping had flattened
    Hue formulas used to run unclamped and wrap in hsv(). Where the top layer
    goes past 1 it is now mod: true. 39 net.hue and 21 map_fiber.hue had a
    negative inner term that clamped to 0, so they are rewritten as a
    subtraction instead.
2026-11-05 v3: the mod flag is a switch that reads clamp or wrap
2026-11-05 v3: the mod switch is just labelled mod
2026-11-05 v3: a hue slot keeps its mod switch through the wheel
2026-11-05 v3: a wrapping inner layer is no longer mistaken for the wheel's width
2026-11-05 v3: operators with any number of arguments
    Port the desktop page to the operators server: trees are {op, args: [...]}
    rather than {op, a, b}.
    - Tree helpers, text form, hue wheel, fader split and drag-to-trade work on
    argument lists. The gradient stub goes: gradient_N_h/_s are ordinary unary
    operators now.
    - A "..." button beside the glyph row opens a searchable, grouped menu of every
    operator in /rig; one with no glyph is lit by name. Switching operator fits
    the operands to its arity.
    - Layout follows arity: binary keeps its two boxes, unary gets one, n-ary gets
    numbered rows (0-based, matching the select knob) with + operand and a
    per-row cut.
    - Operators written as calls, sel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
2026-11-06 single filament for ambient light
2026-11-08 Sparks: prob is a share of 100 LEDs, so a 0-1 slot can ask for a lot
    Sparks read its prob slot as the number of LEDs lit at once, 15 for about 15.
    A formula is now held to 0-1 where it is evaluated, so a slot on a fader could
    never ask for more than about one: 100 x fader_a came out as 1.
    prob is now that count as a share of Sparks.MAX_SPARKS, 100. 0.15 asks for about
    15 lit, 0.5 for 50, 0.99 for about 100 (a tenth of the rig's 960 LEDs). A fader
    on prob runs the whole range with no multiplier.
    migrations/2026-11-05-sparks-prob-scale rewrote the ten presets that set it, so
    each still asks for the same count: constants divided by 100, and the x100 on
    preset 31 (and x20 on 37 and 39) folded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
2026-11-08 Gradients: a knob picks one by index, and a preset can carry its own
    A gradient is (frac, hue, sat) stops sampled by gradient_hs. A knob is on the
    gradient at exactly its index, 0-127, and on none where nothing is (it reads 0).
    0-63 are the gradients declared in code, by their order in an append-only list.
    64-127 are the playing preset's own, by their order in its gradients list.
    The chooser looks the gradient up on the playing patch (or the declared ones in
    code) when it is asked, so nothing is copied from the patch into the renderer
    when a preset is applied. A preset with more than 64 of its own, or one with no
    stops, is refused when it is written. Files that keyed their gradients by name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
2026-11-08 v3: choose, make and change colour gradients
    A gradient is stops of [frac, hue, sat], drawn in the page by a port of the
    server's gradient_hs, so what a preview shows is what the rig plays.
    - A knob row for gradient_N.select shows the gradient it is on as a strip, and
    a menu of every gradient with its preview: the preset's own, the declared
    ones, and "new gradient". Choosing one is choosing its position.
    - Each hue/sat pair on an effect (hue and sat, hue_1 and sat_1) gets a gradient
    row that writes gradient_N_h and gradient_N_s of one driver into both slots
    and points the channel's knob at the gradient. Both slots stay editable. A new
    pair takes a channel nothing else reads - glit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
2026-11-08 v3: show an effect's own controls
    CONTROLS.md names three kinds of owner - field, operator, effect - and v3 only
    knew the first two, so a control an effect keeps for itself (prob_zaps.length,
    the zap length; ambient_light.target) was nowhere on the page except as a dial
    on a slot that happened to name something that shared its owner. Mobile already
    found them: a control is an effect's when it is named effect.role.
    - controlsOwnedBy(name) takes every control named name.*, exactly, as a field
    does, so bg_waves does not pick up bg_waves2's.
    - An open effect card shows them at the top, above its slots: they are not
    behind any slot, so they are on show for as long as the effect is.
    - The con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
2026-11-09 Gradients: hue goes the short way round between two stops
    A gradient interpolated hue as a plain number, so 0.95 to 0.01 swept back through
    every other colour and pink, red, orange squeezed a whole spectrum between 0.99
    and 1.01. Hue is a circle: it now takes the shorter way, and is returned in 0-1.
    Saturation is unchanged, and so is every gradient in the code and in the presets
    (none has a hue step of more than half the wheel).
2026-11-09 Gradients: a near-white stop is white, and takes its neighbour's hue
    Hue is the direction away from the centre of the wheel, and at the centre there is
    none. A stop with saturation under 0.1 is now exactly white, and a segment that
    ends at one keeps the other stop's hue all the way: arriving at white holds the
    colour you came from, and leaving it heads straight for the next, with no detour
    through whatever hue the white stop was carrying (a violet-blue one sent pink and
    violet into the way out of white). Two saturated stops far apart still go the short
    way round the wheel. color_temp_bright and roygbv_rainbow are unchanged.
2026-11-09 v3: draw white stops as the server plays them, and snap the wheel to white
    A drop within 0.1 of the centre of the colour wheel is saturation 0. The strip and
    preview follow the same rule as the server, and the editor's help says so.
